moonkongv2/first-bike-moto-mod/README.md

# First Bike Moto Mod

A DIY project that adds motorcycle-inspired sound, lights, and controls to a FirstBIKE balance bike.

퍼스트바이크에 시동음, LED, 스위치를 추가해 작은 오토바이처럼 만들어보는 DIY 프로젝트입니다.

🌐 **[View the build log / 제작기 보기](https://moonkongv2.github.io/first-bike-moto-mod/)**

🎬 **[Watch the finished bike on Instagram / 완성 모습 보기](https://www.instagram.com/reel/Dcsc5PiyJVf/)**

## Documentation

- [한국어](ko/README.md)
- [English](en/README.md)

## Build Log

The completed build is documented in five short episodes, available in both Korean and English.

1. Getting Started / 프로젝트 시작
2. Prototyping the Circuit / 브레드보드 회로 테스트
3. Building the Circuit for the Bike / 실제 회로 제작
4. Enclosure & Installation / 케이스와 자전거 설치
5. Final Build & Improvements / 완성과 개선점

## Repository Structure

```text
first-bike-moto-mod/
├── README.md
├── index.md
├── _config.yml
├── ko/
│   ├── README.md
│   ├── 01-start.md
│   ├── 02-prototype.md
│   ├── 03-circuit-build.md
│   ├── 04-enclosure.md
│   └── 05-final.md
├── en/
│   ├── README.md
│   ├── 01-start.md
│   ├── 02-prototype.md
│   ├── 03-circuit-build.md
│   ├── 04-enclosure.md
│   └── 05-final.md
├── arduino/
│   └── first_bike_moto_mod/
│       └── first_bike_moto_mod.ino
└── assets/
    └── images/
```

The build is complete; future updates will focus on small refinements such as speaker volume and enclosure size. 🏍️
