moonkongv2/first-bike-moto-mod/index.md

---
layout: default
title: First Bike Moto Mod
---

# First Bike Moto Mod 🏍️

A DIY project that adds motorcycle-inspired lights, sound, and controls to a FirstBIKE balance bike.

퍼스트바이크에 시동음, LED, 스위치를 추가해 작은 오토바이처럼 만들어보는 DIY 프로젝트.

> 🎬 [Watch the finished bike on Instagram / 완성 모습 보기](https://www.instagram.com/reel/Dcsc5PiyJVf/)

## Build Log

- 🇰🇷 [한국어 제작기](ko/)
- 🇺🇸 [English Build Log](en/)

This site documents the build process, including the prototype, circuit design, enclosure, waterproofing, and final installation.
