moonkongv2/first-bike-moto-mod/ko/05-final.md

---
layout: default
title: "05. 완성과 개선점"
---

# 05. 완성과 개선점

> 🎬 **완성 모습 보기:** 실제 동작 모습은 [Instagram Reel에서 짧은 영상으로 볼 수 있다](https://www.instagram.com/reel/Dcsc5PiyJVf/).

브레드보드에서 시작했던 회로를 만능기판으로 옮기고, 케이스에 넣고, 배선과 방수 처리까지 끝냈다.

그리고 드디어 퍼스트바이크에 실제로 장착했다.

처음 목표로 했던 기능은 모두 구현됐다.

**스위치 ON → 시동음 재생 → LED ON**

아주 단순한 동작이지만, 처음 머릿속으로 생각했던 기능이 실제 자전거에서 그대로 동작하는 걸 보니 꽤 만족스러웠다.

(뜬금 없이 검정 박스가 달려있는게 약간 밤티나긴 했지만 나름 최선이었다.)

<p align="center">
  
</p>

<p align="center">
  <em>최종 완성된 First Bike Moto Mod</em>
</p>

## 생각보다 많은 걸 만들었다

처음에는 스위치 하나와 시동음 정도면 금방 만들 수 있을 줄 알았다.

그런데 실제로 자전거에 설치하려고 하니 생각해야 할 것이 계속 늘어났다.

- 배터리와 전원 공급
- Arduino와 DFPlayer 제어
- 스피커
- LED
- 납땜과 만능기판
- 케이스 내부 배치
- 외부 배선
- 방수
- 자전거에 고정하는 방법

전자회로를 만드는 것보다 **그 회로를 실제 환경에서 쓸 수 있는 형태로 만드는 과정**에서 더 많은 고민을 했던 것 같다.

## 가장 아쉬운 건 소리

실제로 밖에서 사용해보니 가장 아쉬운 부분은 스피커 음량이었다.

책상 위에서는 충분히 들렸지만, 야외에서는 주변 소음 때문에 DFPlayer에 직접 연결한 작은 스피커만으로는 시동음이 조금 약하게 느껴졌다.

DFPlayer의 볼륨은 이미 최댓값까지 사용하고 있기 때문에 단순히 코드에서 더 키울 수도 없다.

그래서 이후에는 조금 더 출력이 큰 스피커를 사용하거나, 필요하다면 작은 앰프를 추가하는 방법도 검토하고 있다.

다만 케이스 내부 공간이 매우 제한적이라 **음량과 크기 사이에서 적당한 타협점을 찾는 것**이 다음 과제가 될 것 같다.

## 만들면서 가장 재미있었던 부분

이번 프로젝트에서 가장 재미있었던 건 특별한 기술을 새로 사용했다는 것보다는,

**아이의 작은 관심 하나를 실제 동작하는 물건으로 만들어보는 과정**이었다.

길에서 오토바이를 보며 시동이 걸려 있는지, 불이 켜져 있는지를 관찰하던 모습에서 시작해,

그 기능을 아이가 타는 자전거에도 만들어주면 재미있겠다는 단순한 생각이 실제 회로와 케이스, 배선으로 이어졌다.

그리고 그 과정에서 예상하지 못했던 문제들을 하나씩 해결하다 보니 결과적으로 꽤 많은 것을 배우게 됐다.

<p align="center">
  
</p>

<p align="center">
  <em>완성 후 실제로 사용하는 모습</em>
</p>

## 개선한다면

현재 상태로도 처음 계획했던 목적은 충분히 달성했다.

그래도 다시 개선한다면 몇 가지 해보고 싶은 것이 있다.

* 컴팩트하고 깔끔한 외장 및 하우징
* 더 큰 스피커 또는 소형 앰프 적용
* 필요하다면 새로운 사운드나 기능 추가

PCB, 회로 관련하여 하도 검색하다 보니 맞춤 광고에 아예 맞춤 PCB 광고가 계속 뜨던데 이건 좀 욕심이 났다.

사실 현재 구현된 기능만 보면 arduino nano도 오버 스펙이라서 필요한 기능만 골라넣은 PCB를 제작한다면 훨씬 더 컴팩트하고 멋지게 만들어 줄 수 있지 않을까...

하지만 우선은 여기까지.

**아이의 퍼스트바이크를 조금 더 진짜 오토바이처럼 만들어보기.**

그게 이 프로젝트의 목표였고, 생각했던 것보다 훨씬 재미있는 DIY 프로젝트가 됐다.

---

[← 04. 케이스와 자전거 설치](04-enclosure.html) · [제작기 목록](index.html)

🌐 [English version](../en/05-final.html)
