moonkongv2/first-bike-moto-mod/ko/04-enclosure.md

---

layout: default
title: "04. 케이스와 자전거에 설치하기"
---

# 04. 케이스와 자전거에 설치하기

> 🎬 **완성 모습 먼저 보기:** 완성된 모습이 궁금하다면 [Instagram Reel에서 짧은 영상 보기](https://www.instagram.com/reel/Dcsc5PiyJVf/).

회로가 완성됐으니 이제 실제 자전거에 올릴 차례였다.

가장 먼저 한 일은 **케이스 안에 정말 다 들어가는지 확인하는 것**이었다.

실제 ABS 박스를 바로 가공하기 전에, 비슷한 크기로 박스를 잘라 간단한 목업을 만들고 그 안에 기판, 배터리, 스피커를 넣어보면서 배치를 먼저 잡았다.

<p align="center">
  
</p>

<p align="center">
  <em>실제 케이스 크기에 맞춰 먼저 배치를 확인해본 과정</em>
</p>

## 생각보다 어려웠던 케이스 가공

최종적으로는 방수 ABS 케이스를 사용했다.

문제는 스위치와 LED 배선이었다.

스위치를 끼울 구멍과 LED 케이블이 밖으로 나갈 구멍을 직접 뚫어야 했는데, 생각보다 깔끔하게 가공하기가 어려웠다.

결과적으로 구멍은 꽤 러프하게 뚫렸지만, 어차피 중요한 건 부품이 들어가고, 물이 들어오지 않는 것이었다.

심지어 LED 케이블 구멍은 인두기로 녹여서 뚫고 주변을 다듬어 줬다.

그래서 케이블과 스위치가 통과하는 부분은 **중성경화 실리콘으로 충분히 막아 틈을 메웠다.**

<p align="center">
  
</p>

<p align="center">
  <em>가정용 드릴과 니퍼로 씨름하며 만들어낸 스위치 구멍</em>
</p>

## 실제 자전거에 장착

케이스 안에 회로와 배터리를 넣고, 외부로 나온 배선을 스위치와 LED에 연결했다.

스위치는 아이가 쉽게 조작할 수 있는 위치에 두고, LED는 앞쪽에 설치했다.

그리고 전원을 켜봤다.

**시동음이 재생되고 LED가 켜졌다.**

브레드보드에서 시작했던 회로가 드디어 실제 자전거에 올라간 순간이었다.

<p align="center">
  
</p>

<p align="center">
  <em>퍼스트바이크에 실제로 장착한 모습</em>
</p>

기능적으로는 이제 거의 완성됐다.

다음 편에서는 최종 결과와 실제로 사용하면서 느낀 점, 그리고 개선하고 싶은 부분을 정리해보려고 한다.

---

[← 03. 실제 회로 제작](03-circuit-build.html) · [제작기 목록](index.html) · [05. 완성과 개선점 →](05-final.html)

🌐 [English version](../en/04-enclosure.html)
