moonkongv2/first-bike-moto-mod/ko/02-prototype.md

---
layout: default
title: "02. 브레드보드에서 회로 테스트하기"
---

# 02. 브레드보드에서 회로 테스트하기

> 🎬 **완성 모습 먼저 보기:** 이 글은 제작 과정 기록이야. 완성된 모습이 궁금하다면 [Instagram Reel에서 짧은 영상 보기](https://www.instagram.com/reel/Dcsc5PiyJVf/).

내가 정한 목표는 단순했다.

**스위치를 켜면 시동음이 나고, 불이 켜지는 것.**

하지만 실제 자전거에 부품을 달고 납땜하기 전에, 이 구성이 정말 원하는 대로 동작하는지부터 확인할 필요가 있었다.

그래서 먼저 브레드보드 위에서 회로를 임시로 연결해보기로 했다.

아직 예쁘게 만들 필요도 없고, 크기를 줄일 필요도 없다.

일단 **“되는지 확인하는 것”**이 이번 단계의 목표였다.

<p align="center">
  
</p>

<p align="center">
  <em>Arduino Nano와 DFPlayer Mini를 브레드보드에 임시로 연결한 모습</em>
</p>

## 먼저 시동음부터

가장 먼저 확인하고 싶었던 건 소리였다.

구성은 다음과 같이 단순하게 시작했다.

* Arduino Nano
* DFPlayer Mini
* microSD 카드
* 스피커

DFPlayer Mini는 microSD 카드에 들어 있는 MP3 파일을 재생할 수 있는 작은 모듈이다.

Arduino Nano에서 DFPlayer로 명령을 보내면 지정한 파일을 재생할 수 있어서, 시동음을 구현하기에 적당해 보였다.

microSD 카드에는 오토바이 시동음을 넣고 파일명을 DFPlayer가 인식할 수 있도록 맞춰줬다.

Arduino에서는 `DFRobotDFPlayerMini` 라이브러리를 사용했다.

대략적인 동작은 이렇다.

```text
Arduino 전원 ON
      ↓
DFPlayer 초기화
      ↓
볼륨 설정
      ↓
시동음 MP3 재생
```

처음 테스트에서는 스위치 입력까지 한꺼번에 구현하기보다, Arduino에 전원이 들어오면 시동음 하나를 재생하도록 단순하게 만들었다.

**한 번에 하나씩 확인하는 편이 문제가 생겼을 때 원인을 찾기 쉬울 것 같았다.**

## 첫 번째 난관은 회로가 아니었다

그런데 정작 처음 막힌 건 회로가 아니라 Arduino 개발 환경이었다.

라이브러리를 설치한 뒤 코드를 업로드하려고 했는데 Arduino Nano가 컴퓨터에서 제대로 인식되지 않았다.

사용하던 케이블은 정품 USB-C 케이블이었기 때문에 당연히 데이터 통신도 될 거라고 생각했는데, Arduino IDE에서는 포트가 나타나지 않았다.

결국 다른 USB 케이블과 젠더 조합으로 바꿔보니 바로 인식됐다.

전자회로 문제를 예상하고 있었는데 시작부터 케이블 때문에 막힐 줄은 몰랐다.

어쨌든 Arduino에 코드를 업로드할 수 있게 되었고, 이제 정말 회로 테스트를 시작할 수 있었다.

## 드디어 시동음이 나왔다

Arduino와 DFPlayer를 연결하고 스피커까지 연결한 뒤 전원을 넣었다.

그리고 잠시 후,

**스피커에서 시동음이 재생됐다.**

일단 가장 핵심적인 아이디어가 실제로 구현 가능하다는 것을 확인한 순간이었다.

하지만 여기서 끝은 아니었다.

여러 번 전원을 껐다 켜고 Arduino의 Reset 버튼을 눌러보니 이상한 점이 하나 있었다.

처음 전원을 연결했을 때와 Reset 버튼을 눌러 다시 실행했을 때 **스피커 볼륨이 다르게 들렸다.**

## 같은 코드인데 왜 볼륨이 다르지?

코드에서는 DFPlayer의 볼륨을 최댓값인 `30`으로 지정하고 있었다.

그런데 전원을 처음 넣었을 때는 설정한 볼륨이 제대로 적용되지 않는 것처럼 들렸다.

원인을 확인하면서 DFPlayer가 전원을 받은 직후 바로 준비되는 것이 아니라, 초기화에 약간의 시간이 필요하다는 것을 알게 됐다.

그래서 DFPlayer 초기화 이후 잠깐 기다린 다음 볼륨을 설정하도록 코드를 수정했다.

몇 번 시간을 바꿔가며 테스트해보니 현재 구성에서는 약 **300ms 정도의 대기 시간**을 주었을 때 안정적으로 동작했다.

```cpp
delay(300);
player.volume(30);
```

아주 짧은 코드지만 실제 동작에는 꽤 큰 차이가 있었다.

이런 종류의 모듈은 단순히 선만 맞게 연결한다고 끝나는 게 아니라, **전원이 들어온 뒤 준비되는 시간까지 고려해야 한다는 것**도 이번에 처음 체감했다.

## 갑자기 전압이 떨어졌다

테스트를 계속하다가 또 다른 문제가 생겼다.

어느 순간 DFPlayer와 스피커가 제대로 동작하지 않았고, 멀티미터로 전압을 측정해보니 예상보다 훨씬 낮은 값이 나오고 있었다.

처음에는 전원 공급 장치나 DFPlayer 문제를 의심했다.

그래서 보조배터리 말고 5V 충전기에 연결해서 테스트도 해보고 스페어로 주문한 DFPlayer로 교체도 해보았다.

하지만 하나씩 확인해보니 원인은 의외로 **브레드보드의 접촉 불량**이었다.

배선을 다시 꽂고 회로를 정리하자 정상적인 전압이 나오기 시작했고, DFPlayer도 다시 제대로 동작했다.

<p align="center">
  
</p>

<p align="center">
  <em>문제가 생길 때마다 멀티미터로 전압을 확인했다</em>
</p>

(TMI: 대학생 시절 라즈베리파이가 공모전 시연 일주일 전에 자꾸 이유없이 죽어버려서 원인을 찾느라 지옥 같은 시간을 보낸 경험이 있었는데, 원인이 저가 충전기의 불안정한 전원 공급이였다.)

이때부터 회로가 이상하게 동작하면 코드를 먼저 의심하기보다,

**“전압이 제대로 들어오고 있는가?”**

를 먼저 확인하는 습관이 생겼다.

## 스위치와 LED도 붙여보기

시동음 재생이 안정적으로 동작하는 것을 확인한 뒤에는 처음 계획했던 입력과 출력도 하나씩 추가했다.

스위치 상태를 Arduino가 읽고,

스위치를 켜면 시동음을 재생하면서 LED에도 전원이 공급되는 형태로 회로를 확장했다.

최종적으로 만들고 싶은 흐름은 그대로였다.

```text
스위치 OFF
   ↓
아무 동작 없음

스위치 ON
   ↓
Arduino 동작
   ↓
시동음 1회 재생
   +
LED ON
```

여기까지 브레드보드에서 확인하면서 처음 생각했던 기능들이 최소한 전자회로 수준에서는 구현 가능하다는 확신이 생겼다.

<p align="center">
  
</p>

<p align="center">
  <em>브레드보드에서의 최종 구성</em>
</p>

## 이제 진짜 자전거에 넣을 회로로

브레드보드에서는 선이 길어도 되고, 부품이 여기저기 흩어져 있어도 상관없다.

방수도 필요없다.

하지만 실제 자전거에서는 전혀 다른 문제였다.

Arduino, DFPlayer, 전원 회로, 배터리 등을 작은 ABS 케이스 안에 넣어야 하고, 흔들리는 자전거에서도 배선이 빠지지 않아야 한다.

LED 밝기도 조절하고 싶었고, 배터리에서 안정적으로 5V를 공급하는 방법도 필요했다.

그리고 무엇보다 브레드보드는 그대로 자전거에 달 수 없다.

다음 단계에서는 브레드보드에서 검증한 회로를 바탕으로 **실제로 사용할 부품을 선정하고, 만능기판에 납땜해서 하나의 회로로 만드는 과정**을 정리해보려고 한다.

---

[← 01. 프로젝트 시작](01-start.html) · [제작기 목록](index.html) · [03. 실제 회로 제작 →](03-circuit-build.html)

🌐 [English version](../en/02-prototype.html)
