moonkongv2/first-bike-moto-mod/ko/index.md

---
layout: default
title: First Bike Moto Mod — 한국어 제작기
---

# First Bike Moto Mod — 한국어 제작기

퍼스트바이크에 시동음, LED, 스위치를 추가해 작은 오토바이처럼 만들어보는 DIY 프로젝트의 제작 과정을 기록한다.

> 🎬 **완성 모습 먼저 보기:** [Instagram Reel에서 짧은 영상 보기](https://www.instagram.com/reel/Dcsc5PiyJVf/)

## 제작기

1. [프로젝트 시작 — 퍼스트바이크를 오토바이처럼](01-start.html)
2. [브레드보드에서 회로 테스트하기](02-prototype.html)
3. [실제 사용할 회로 만들기](03-circuit-build.html)
4. [케이스와 자전거에 설치하기](04-enclosure.html)
5. [완성과 개선점](05-final.html)

[← 프로젝트 홈으로](../)
