moonkongv2/first-bike-moto-mod/en/index.md

---
layout: default
title: First Bike Moto Mod — Build Log
---

# First Bike Moto Mod — Build Log

A build log for a DIY project that adds motorcycle-inspired lights, sound, and controls to a FirstBIKE balance bike.

> 🎬 **Want to see the finished bike first?** [Watch the short Instagram Reel](https://www.instagram.com/reel/Dcsc5PiyJVf/).

## Build Log

1. [Getting Started — Turning a FirstBIKE into a Little Motorcycle](01-start.html)
2. [Prototyping the Circuit on a Breadboard](02-prototype.html)
3. [Building the Circuit for the Bike](03-circuit-build.html)
4. [Enclosure and Bike Installation](04-enclosure.html)
5. [Final Build and Improvements](05-final.html)

[← Back to project home](../)
