moonkongv2/first-bike-moto-mod/assets/images/02-breadboard-overview2.jpg

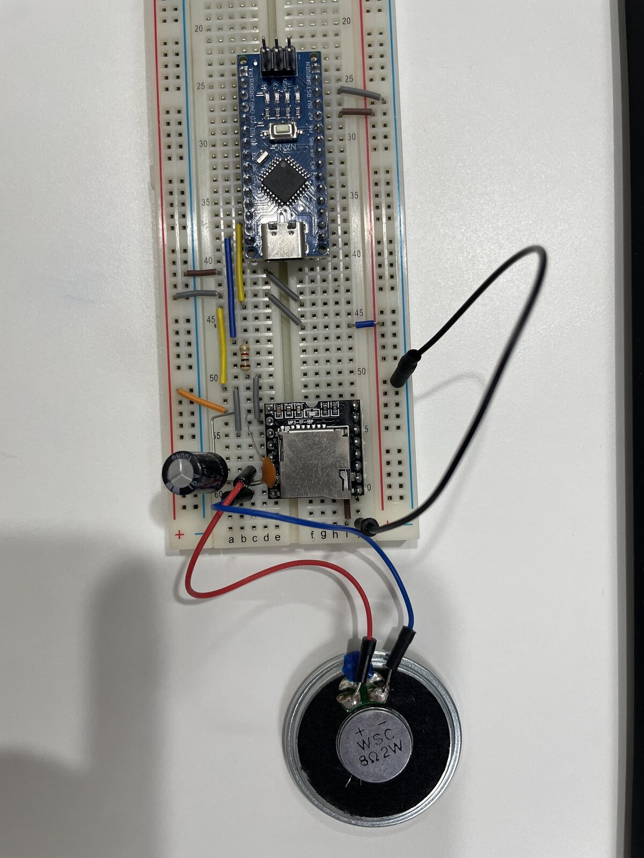
assets/images/02-breadboard-overview2.jpg
