moonkongv2/first-bike-moto-mod/assets/images/circuit_early_design.png

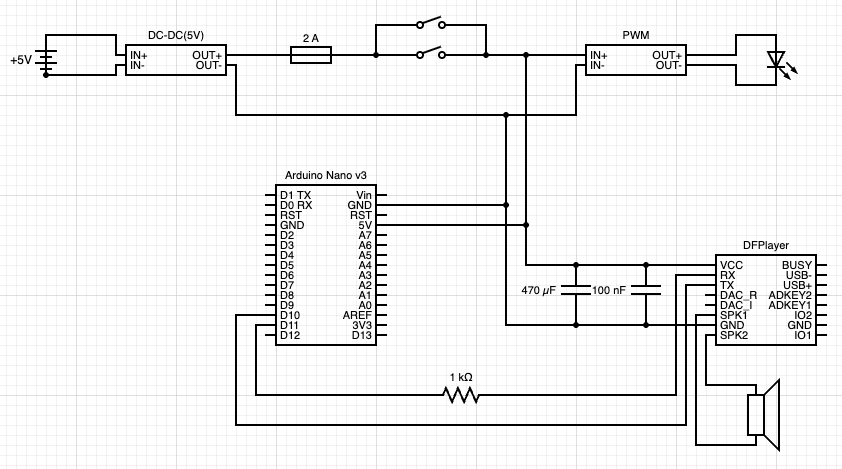
assets/images/circuit_early_design.png
