moonkongv2/first-bike-moto-mod/(commit log)

2026-09-01 arduino nano source code
2026-09-01 02-prototype update(ko) with photos
2026-09-01 update 02-prototype
2026-09-01 docs: add English prototype build log
2026-09-01 docs: add GitHub Pages landing page
2026-09-01 update 03-circuit_build
2026-09-01 docs: add English circuit build log
2026-09-01 fix: correct Jekyll front matter for Korean circuit post
2026-09-01 docs: link Korean circuit build post
2026-09-01 docs: link English circuit build post
2026-09-02 Update 04-enclosure
2026-09-02 docs: add English enclosure and installation post
2026-09-03 docs: align Korean circuit post with final build
2026-09-03 docs: align English circuit post with final build
